huzi-ctrl/midi-keyboard/BOM.csv

Item | Purpose | Qty | Supplier | Price | Tax | Shipping | Total Cost | Link
ESP32-C3 SuperMini Dev Board 160MHz WiFi Compact (U1) | Main microcontroller development board | 1 | Amazon UK | 4.58 | 0.0 | 0.0 | 4.58 | https://www.amazon.co.uk/dp/B0HF8GN9B6
5 PCS PCF8574AP DIP-16 Remote 8-bit I/O Expander Chip (U2) | 8-bit I2C GPIO expander for 3x3 key matrix and encoder switch | 1 | eBay UK (Ele-parts) | 4.21 | 0.0 | 3.14 | 7.35 | https://www.ebay.co.uk/
2227MC-16-03-09-F1 - IC Socket, DIL, 0.3" / 7.62mm, 16 Way (SC15337) | DIP-16 socket for PCF8574AP I2C expander IC | 1 | CPC Farnell (Preston Collection) | 0.29 | 0.06 | 0.0 | 0.35 | https://cpc.farnell.com/multicomp-pro/2227mc-16-03-09-f1/ic-socket-dil-0-3-7-62mm-16-way/dp/SC15337
Kailh Low Profile Choc Brown V1 - 10 Pack (SW6-SW14) | 9 low-profile mechanical switches for 3x3 keypad matrix | 1 | Thocc Exchange UK | 4.5 | 1.25 | 2.99 | 7.49 | https://thoccexchange.com/
200PCS SK6812 Mini-E RGB 3228 SMD Pixels LED (D1-D5, D15-D25) | 16 reverse-mount addressable RGB LEDs for keys and status | 1 | Amazon UK (Vklopdsh) | 5.53 | 0.0 | 0.0 | 5.53 | https://www.amazon.co.uk/
ALPS ALPINE EC12E2424407 Rotary Encoder, Vertical, 24 Det, 24PPR + Switch (SW4 - RE04233) | Rotary encoder with pushbutton switch | 1 | CPC Farnell (Preston Collection) | 1.61 | 0.32 | 0.0 | 1.93 | https://cpc.farnell.com/alps-alpine/ec12e2424407/rotary-encoder-vertical-24-det/dp/RE04233
MULTICOMP PRO 1N4148 (DO-35) Small Signal Diode (D6-D14 - SC15554) | 9 anti-ghosting diodes for 3x3 switch matrix | 10 | CPC Farnell (Preston Collection) | 0.03 | 0.06 | 0.0 | 0.36 | https://cpc.farnell.com/multicomp-pro/1n4148-do-35/small-signal-diode-single-100/dp/SC15554
PANASONIC EEUFM1E470 Electrolytic Capacitor, 47 uF, 25 V, Radial (C1 - CA09929) | Bulk decoupling capacitor for +5V LED power rail | 5 | CPC Farnell (Preston Collection) | 0.23 | 0.23 | 0.0 | 1.38 | https://cpc.farnell.com/panasonic/eeufm1e470/capacitor-47uf-25v/dp/CA09929
MULTICOMP PRO MCKPT-G1210-3916 Piezo Buzzer, 12V, 4.5kHz, 12.2mm (BZ1 - SN36947) | 12mm passive piezo buzzer for audio feedback | 1 | CPC Farnell (Preston Collection) | 0.5 | 0.1 | 0.0 | 0.6 | https://cpc.farnell.com/multicomp-pro/mckpt-g1210-3916/piezo-buzzer-12v-4-5khz-12-2mm/dp/SN36947
MULTICOMP PRO MCF 0.25W 100R Resistor, 0.25W 5% 100R, 100 Pack (R3 - RE03791) | 100 Ohm series current-limiting resistor for piezo buzzer | 1 | CPC Farnell (Preston Collection) | 1.31 | 0.26 | 0.0 | 1.57 | https://cpc.farnell.com/multicomp-pro/mcf-0-25w-100r/resistor-0-25w-5-100r-100pk/dp/RE03791
MULTICOMP PRO MCF 0.25W 4K7 Resistor, 0.25W 5% 4K7, 100 Pack (R1, R2 - RE03811) | 4.7k Ohm I2C pull-up resistors for SDA and SCL | 1 | CPC Farnell (Preston Collection) | 0.93 | 0.19 | 0.0 | 1.12 | https://cpc.farnell.com/multicomp-pro/mcf-0-25w-4k7/resistor-0-25w-5-4k7-100pk/dp/RE03811
MULTICOMP MCRR50104X7RK0050 Capacitor, 100nF, 50V (C2-C17 - CA06296) | 16 ceramic 100nF decoupling capacitors for SK6812MINI-E LEDs | 20 | CPC Farnell (Preston Collection) | 0.081 | 0.32 | 0.0 | 1.94 | https://cpc.farnell.com/multicomp/mcrr50104x7rk0050/capacitor-100nf-50v/dp/CA06296
Bourns PTA1543 10k Ohm Linear Slide Potentiometer (RV1, RV2) | Linear slide potentiometers for analog fader inputs SLIDE1 and SLIDE2 | 0 | CPC Farnell / LCSC | 0.85 | 0.0 | 0.0 | 0.0 | https://cpc.farnell.com/
