huzi-ctrl/midi-keyboard/MIDI starter.kicad_sch

## KiCad design MIDI starter.kicad_sch (2026-10-26)

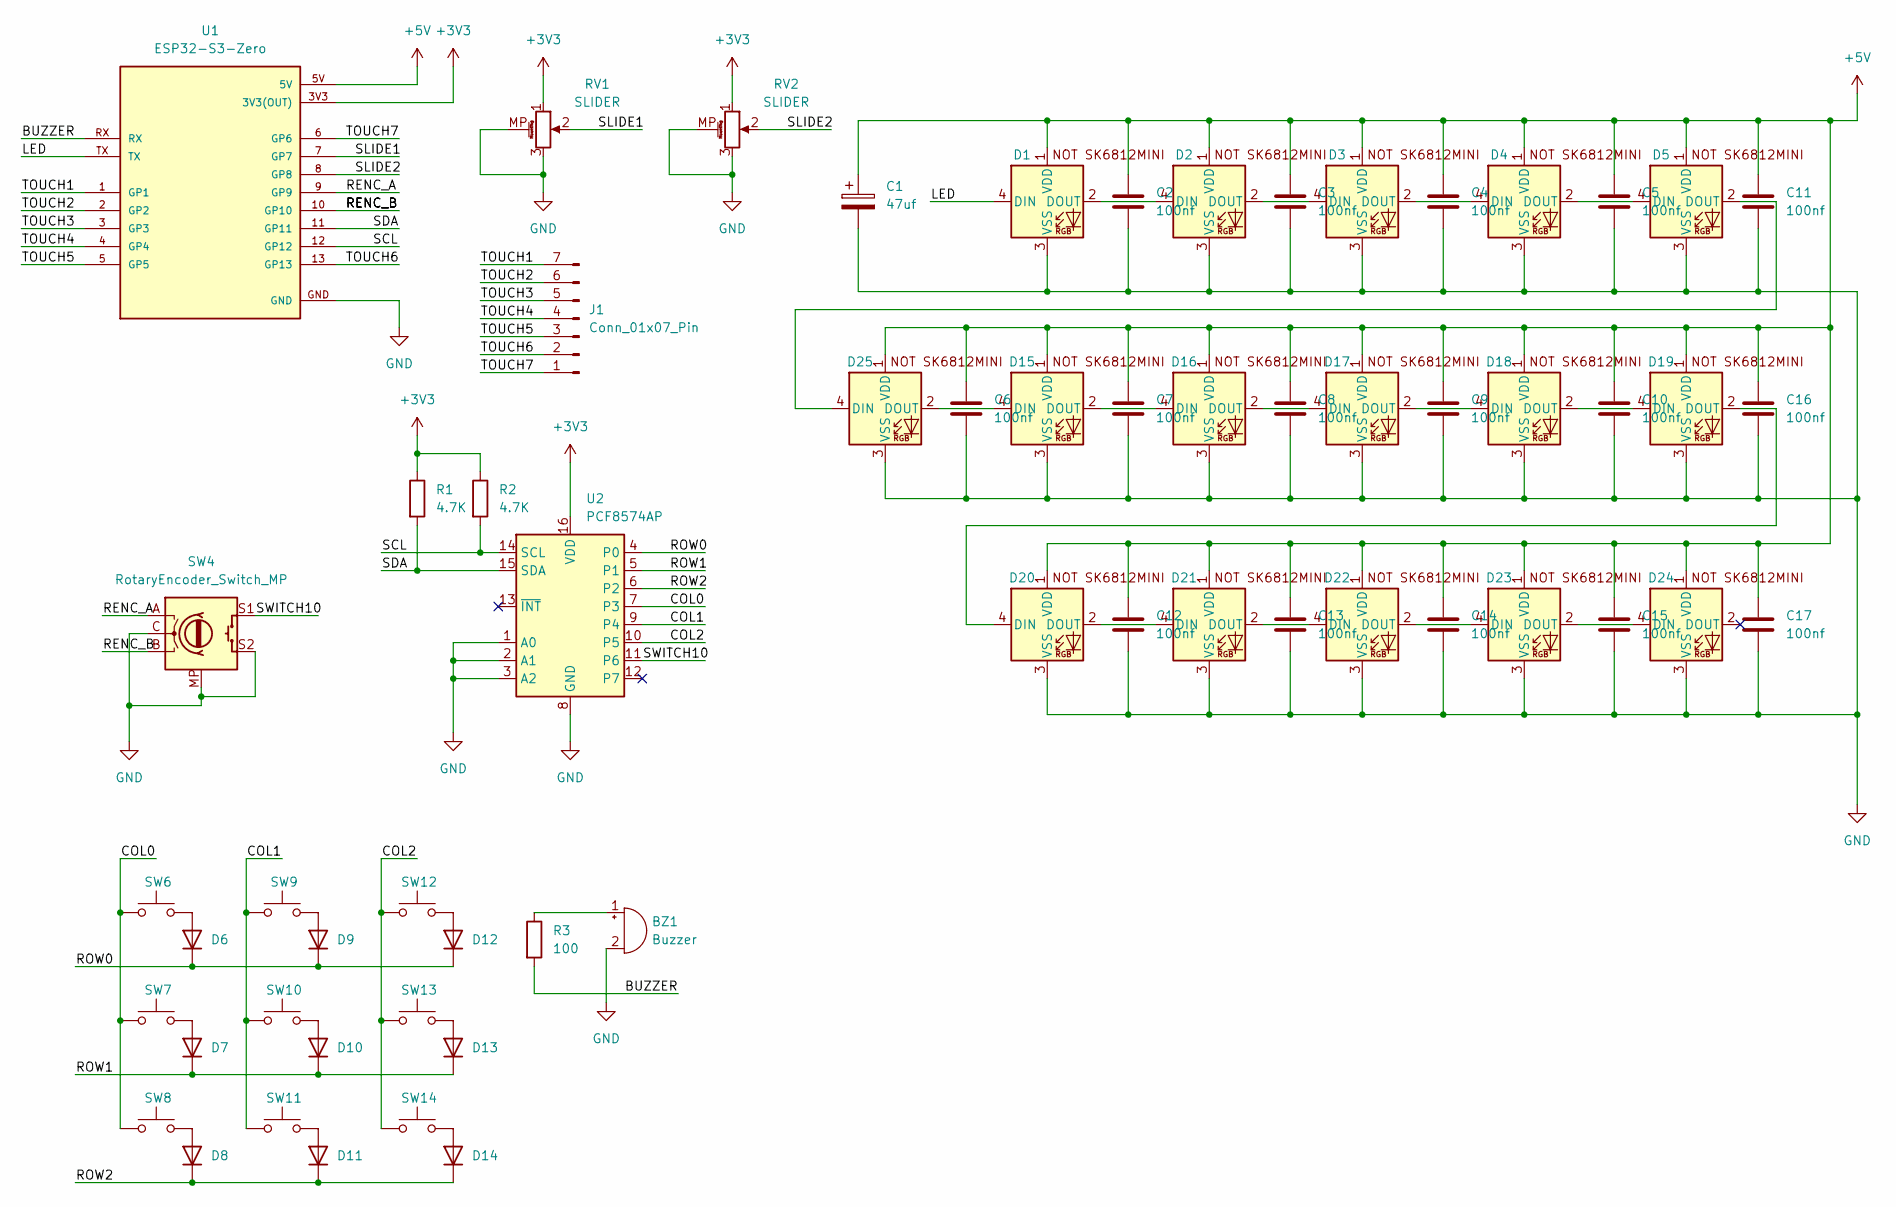
[picture p3: schematic MIDI starter.kicad_sch]

Parts:
BZ1: Buzzer; Buzzer_12x9.5RM7.6
C1: 47uf; CP_Radial_D8.0mm_P3.50mm
C2, C3, C4, C5, C6, C7, C8, C9, C10, C11, C12, C13, C14, C15, C16, C17: 100nf; C_Disc_D5.0mm_W2.5mm_P5.00mm
D1, D2, D3, D4, D5, D15, D16, D17, D18, D19, D20, D21, D22, D23, D24, D25: SK6812MINI-E; LED_SK6812MINI-E_3.2x2.8mm_P1.5mm_ReverseMount
D6, D7, D8, D9, D10, D11, D12, D13, D14: D; D_DO-35_SOD27_P7.62mm_Horizontal
J1: Conn_01x07_Pin; keys
R1, R2: 4.7K; R_Axial_DIN0207_L6.3mm_D2.5mm_P10.16mm_Horizontal
R3: 100; R_Axial_DIN0207_L6.3mm_D2.5mm_P10.16mm_Horizontal
RV1, RV2: SLIDER; Potentiometer_Bourns_PTA1543_Single_Slide
SW4: RotaryEncoder_Switch_MP; RotaryEncoder_Alps_EC11E-Switch_Vertical_H20mm
SW6, SW7, SW8, SW9, SW10, SW11, SW12, SW13, SW14: SW_Push; Kailh Choc Low-Profile Switches
U1: ESP32-S3-Zero; Waveshare ESP32-S3-Zero; PARTREV NA
U2: PCF8574AP; DIP-16_W7.62mm

Connections:
+3V3: R1.1, R2.1, RV1.1, RV2.1, U1.3V3 (3V3(OUT)), U2.16 (VDD)
+5V: C1.1, C2.1, C3.1, C4.1, C5.1, C6.1, C7.1, C8.1, C9.1, C10.1, C11.1, C12.1, C13.1, C14.1, C15.1, C16.1, C17.1, D1.1 (VDD), D2.1 (VDD), D3.1 (VDD), D4.1 (VDD), D5.1 (VDD), D15.1 (VDD), D16.1 (VDD), D17.1 (VDD), D18.1 (VDD), D19.1 (VDD), D20.1 (VDD), D21.1 (VDD), D22.1 (VDD), D23.1 (VDD), D24.1 (VDD), D25.1 (VDD), U1.5V
BUZZER: R3.2, U1.RX
COL0: SW6.1, SW7.1, SW8.1, U2.7 (P3)
COL1: SW9.1, SW10.1, SW11.1, U2.9 (P4)
COL2: SW12.1, SW13.1, SW14.1, U2.10 (P5)
GND: BZ1.2 (-), C1.2, C2.2, C3.2, C4.2, C5.2, C6.2, C7.2, C8.2, C9.2, C10.2, C11.2, C12.2, C13.2, C14.2, C15.2, C16.2, C17.2, D1.3 (VSS), D2.3 (VSS), D3.3 (VSS), D4.3 (VSS), D5.3 (VSS), D15.3 (VSS), D16.3 (VSS), D17.3 (VSS), D18.3 (VSS), D19.3 (VSS), D20.3 (VSS), D21.3 (VSS), D22.3 (VSS), D23.3 (VSS), D24.3 (VSS), D25.3 (VSS), RV1.3, RV1.MP (MountPin), RV2.3, RV2.MP (MountPin), SW4.C, SW4.MP, SW4.S2, U1.GND, U2.1 (A0), U2.2 (A1), U2.3 (A2), U2.8 (GND)
LED: D1.4 (DIN), U1.TX
unnamed: BZ1.1 (+), R3.1
unnamed: D1.2 (DOUT), D2.4 (DIN)
unnamed: D2.2 (DOUT), D3.4 (DIN)
unnamed: D3.2 (DOUT), D4.4 (DIN)
unnamed: D4.2 (DOUT), D5.4 (DIN)
unnamed: D6.2 (A), SW6.2
unnamed: D7.2 (A), SW7.2
unnamed: D8.2 (A), SW8.2
unnamed: D9.2 (A), SW9.2
unnamed: D10.2 (A), SW10.2
unnamed: D11.2 (A), SW11.2
unnamed: D12.2 (A), SW12.2
unnamed: D13.2 (A), SW13.2
unnamed: D14.2 (A), SW14.2
unnamed: D15.2 (DOUT), D16.4 (DIN)
unnamed: D15.4 (DIN), D25.2 (DOUT)
unnamed: D16.2 (DOUT), D17.4 (DIN)
unnamed: D17.2 (DOUT), D18.4 (DIN)
unnamed: D18.2 (DOUT), D19.4 (DIN)
unnamed: D19.2 (DOUT), D20.4 (DIN)
unnamed: D20.2 (DOUT), D21.4 (DIN)
unnamed: D21.2 (DOUT), D22.4 (DIN)
unnamed: D22.2 (DOUT), D23.4 (DIN)
unnamed: D23.2 (DOUT), D24.4 (DIN)
unnamed: D5.2 (DOUT), D25.4 (DIN)
RENC_A: SW4.A, U1.9 (GP9)
RENC_B: SW4.B, U1.10 (GP10)
ROW0: D6.1 (K), D9.1 (K), D12.1 (K), U2.4 (P0)
ROW1: D7.1 (K), D10.1 (K), D13.1 (K), U2.5 (P1)
ROW2: D8.1 (K), D11.1 (K), D14.1 (K), U2.6 (P2)
SCL: R2.2, U1.12 (GP12), U2.14 (SCL)
SDA: R1.2, U1.11 (GP11), U2.15 (SDA)
SLIDE1: RV1.2, U1.7 (GP7)
SLIDE2: RV2.2, U1.8 (GP8)
SWITCH10: SW4.S1, U2.11 (P6)
TOUCH1: J1.7, U1.1 (GP1)
TOUCH2: J1.6, U1.2 (GP2)
TOUCH3: J1.5, U1.3 (GP3)
TOUCH4: J1.4, U1.4 (GP4)
TOUCH5: J1.3, U1.5 (GP5)
TOUCH6: J1.2, U1.13 (GP13)
TOUCH7: J1.1, U1.6 (GP6)
