huzi-ctrl/midi-keyboard/JOURNAL.md

# Midi Keyboard – devlog

<!-- Generated by Half Life from project cmvjli8gg02ip01odt3qvgppi. Edits here are overwritten on the next sync. -->
<!-- Generated: 2026-10-25T23:53:58.325Z -->

> [!NOTE]
> This devlog is mirrored from [Half Life](https://halflife.hackclub.com) – [open the project](https://halflife.hackclub.com/projects/cmvjli8gg02ip01odt3qvgppi). Editing it here will not change the platform's copy, and the next sync overwrites this file.

> Learn PCB design by creating your own custom MIDI keypad with switches, sliders, rotary encoders, neopixels and capacitive touch! Added more keys and LEDS

| Week | Tier | Hours logged | Entries |
| --- | --- | --- | --- |
| Week 3 | Tier 1 | 20.42h | 5 |

## Contents

1. [2026-10-23 – Work session](#2026-10-23-work-session)
2. [2026-10-24 – Worked on expanding the project from starter to custom. Added more LEDs by daisy chaining - one for each button capacitive and mechanical and added decoupling caps and a reserve cap for safety. Added](#2026-10-24-worked-on-expanding-the-project-from-starter-to-c)
3. [2026-10-25 – Some errors were present that tripped ERC as well as some finer things like analogue pins being wired up to the io expander that is now fixed by moving around which GPIO connected to what, and moving](#2026-10-25-some-errors-were-present-that-tripped-erc-as-well)
4. [2026-10-25 – ](#2026-10-25-screenshot-2026-10-25-181020httpshalflifehackclub)
5. [2026-10-25 – fixed small issue in wiring with some components not being joined up as they should be but that has been rerouted so everything is wired up correctly now and drc doesnt through any errors so it should](#2026-10-25-fixed-small-issue-in-wiring-with-some-components-)

## Design

### 2026-10-23 – Work session

**0.92h**

[Timelapse](https://lookout.hackclub.com/api/media/83c4dff2-827a-4b7b-8815-aafce9a93f98/video.mp4)

### 2026-10-24 – Worked on expanding the project from starter to custom. Added more LEDs by daisy chaining - one for each button capacitive and mechanical and added decoupling caps and a reserve cap for safety. Added

**3h**

Worked on expanding the project from starter to custom. Added more LEDs by daisy chaining - one for each button capacitive and mechanical and added decoupling caps and a reserve cap for safety. Added a switch matrix for more switches but had to add an IO expander to accommodate the required IO boost, I also added a buzzer sop it doesn't











 need a pc connection to work

### 2026-10-25 – Some errors were present that tripped ERC as well as some finer things like analogue pins being wired up to the io expander that is now fixed by moving around which GPIO connected to what, and moving

**1h**

Some errors were present that tripped ERC as well as some finer things like analogue pins being wired up to the io expander that is now fixed by moving around which GPIO connected to what, and moving what connected to the IO expander





### 2026-10-25 – 

**15h**

































Completed Schematic to PCB. Assigned all footprints and then placed the components on the board - it was a bit difficult to wire everything managed in the end and got the final pcb with everything wired up.

### 2026-10-25 – fixed small issue in wiring with some components not being joined up as they should be but that has been rerouted so everything is wired up correctly now and drc doesnt through any errors so it should

**0.5h**

fixed small issue in wiring with some components not being joined up as they should be but that has been rerouted so everything is wired up correctly now and drc doesnt through any errors so it should be fine.
